ajokela/dual-z80/kz80_production/kz80_bom.csv

Qty | Description | Value | Package | RefDes | Manufacturer Part Number | Notes
3 | Ceramic Capacitor | 100NF | 0805 | C1 C2 C4 |  | Decoupling capacitors
2 | Ceramic Capacitor | 22PF | 0805 | C3 C5 |  | Clock capacitors
2 | Resistor | 33 | 0805 | R1 R2 |  | Clock series resistors
1 | Resistor | 680 | 0805 | R3 |  | LED current limiting resistor
1 | LED | unknown | LED3 | LED1 |  | Bus activity indicator
