ajokela/dual-z80/(list of files, drawings)

Other design files:
kz80.dsn
kz80.pcb
