ajokela/dual-z80/(commit log)

2026-03-07 Initial commit: Dual Z80 RetroShield board
    Shared-bus dual Z80 processor board based on the RetroShield kz80.
    Two Z80 CPUs share address and data buses through a single Arduino
    Mega header, with independent control signals for CPU2 via a 2x6
    pin header. Includes schematics, routed PCB, Gerbers, BOM, and
    pick-and-place files.
    [kz80.dsn, kz80.pcb, kz80.sch, kz80_bom.csv, kz80_centroid.csv, kz80_cpu2.sch]
2026-03-07 Move C5 down to clear J2 header, re-route board
    C5 was overlapping J2's outline. Moved C5 from y=16.51mm to
    y=22.86mm. Full board re-route: 831 traces, 51 vias.
    [kz80.pcb, kz80_centroid.csv]
2026-04-03 Add J2 wiring guide and dual Z80 hardware test sketch
    J2_WIRING_GUIDE.md documents the 2x6 header pinout for the second
    Z80 (U2) control signals and recommended Arduino Mega pin wiring.
    dual_z80_test.ino runs 5 tests to verify both Z80 processors:
    solo execution, shared RAM persistence, processor relay, and
    loop counting. The Arduino emulates RAM and clocks each Z80
    cycle-by-cycle.
2026-04-03 Add SMP kernel demo for dual Z80
    52-byte Z80 kernel implements symmetric multiprocessing: both CPUs
    boot the same code, identify via I/O port, and pull tasks from a
    shared scheduler. Arduino acts as chipset (memory + I/O + scheduler).
    Demo sums 256 bytes: single CPU vs split across both CPUs, with
    exact cycle counts and speedup measurement. Expected ~1.9x speedup.
2026-04-06 Fix ground plane thermal/connected flags shorting bus lines
    Removed erroneous thermal(0X) flag from U1 pin 1 (A11) that was
    connecting the address line to the ground fill. Removed connected
    flags from all non-GND pins (+5V, VCC, WAIT, BUSRQ, LED, caps)
    and all 11 vias that were incorrectly flagged to connect to the
    ground pour. Only J1-18, J1-19, and U1-29 (GND) retain thermal
    connections. Regenerated production gerbers.
    [kz80.bottom.copper.none.6.gbr, kz80.bottom.mask.none.7.gbr, kz80.bottom.silk.none.8.gbr, kz80.drl, kz80.gbl, kz80.gbo, kz80.gbs, kz80.gko]
2026-04-06 Remove bottom ground fill polygon causing bus shorts
    pcb-rnd's Gerber exporter generated incomplete clearance cutouts
    around through-hole pins in the ground fill polygon. Signal pins
    had as little as 0.1mm (4mil) clearance on some sides, with the
    fill contacting pads on other sides — shorting all 24 address and
    data bus lines to GND. Removed the polygon entirely; GND routing
    is handled by explicit traces from the autorouter.
    [kz80.pcb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]
2026-04-06 Add Excellon drill file to production zip
    [kz80.drl]
2026-04-06 Re-route board without ground fill polygon
    Clean re-route after removing the bottom layer ground fill.
    926 trace segments, 49 vias. All GND connections now via
    explicit traces — no dependency on copper fill.
    [kz80.dsn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]
2026-04-06 Re-route with clean GND net, remove orphaned vias
    Previous route had incomplete GND connectivity because 3 pre-existing
    vias with quoted net names confused Freerouting. Removed orphaned vias,
    clean re-route: 834 traces, 58 vias, all 48 nets fully connected
    including GND (10 pins, verified).
    [kz80.dsn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]
2026-04-07 Remove 79 orphaned vias from original RetroShield design
    Pre-existing vias (ground plane stitching and original routing) served
    no purpose after the ground fill polygon was removed. Reduces drill
    count and simplifies the board. 58 autorouted vias retained.
    [kz80.pcb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]
2026-04-07 Clean re-route without orphaned vias
    With 79 pre-existing vias removed, Freerouting achieved 50% better
    optimization. 553 traces, 25 vias (down from 834/58). GND fully
    connected with 17 path segments. Cleaner, shorter traces overall.
    [kz80.dsn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]
2026-04-07 Regenerate BOM and centroid from current PCB layout
    Updated component positions to match current placement.
    Added LED1 to BOM. 9 SMD components total.
    [kz80_bom.csv, kz80_centroid.csv]
2026-04-07 Bump silkscreen revision to Rev C
    [kz80.pcb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]
